Redstar030/AERC_Forklift/resources/sch.pdf

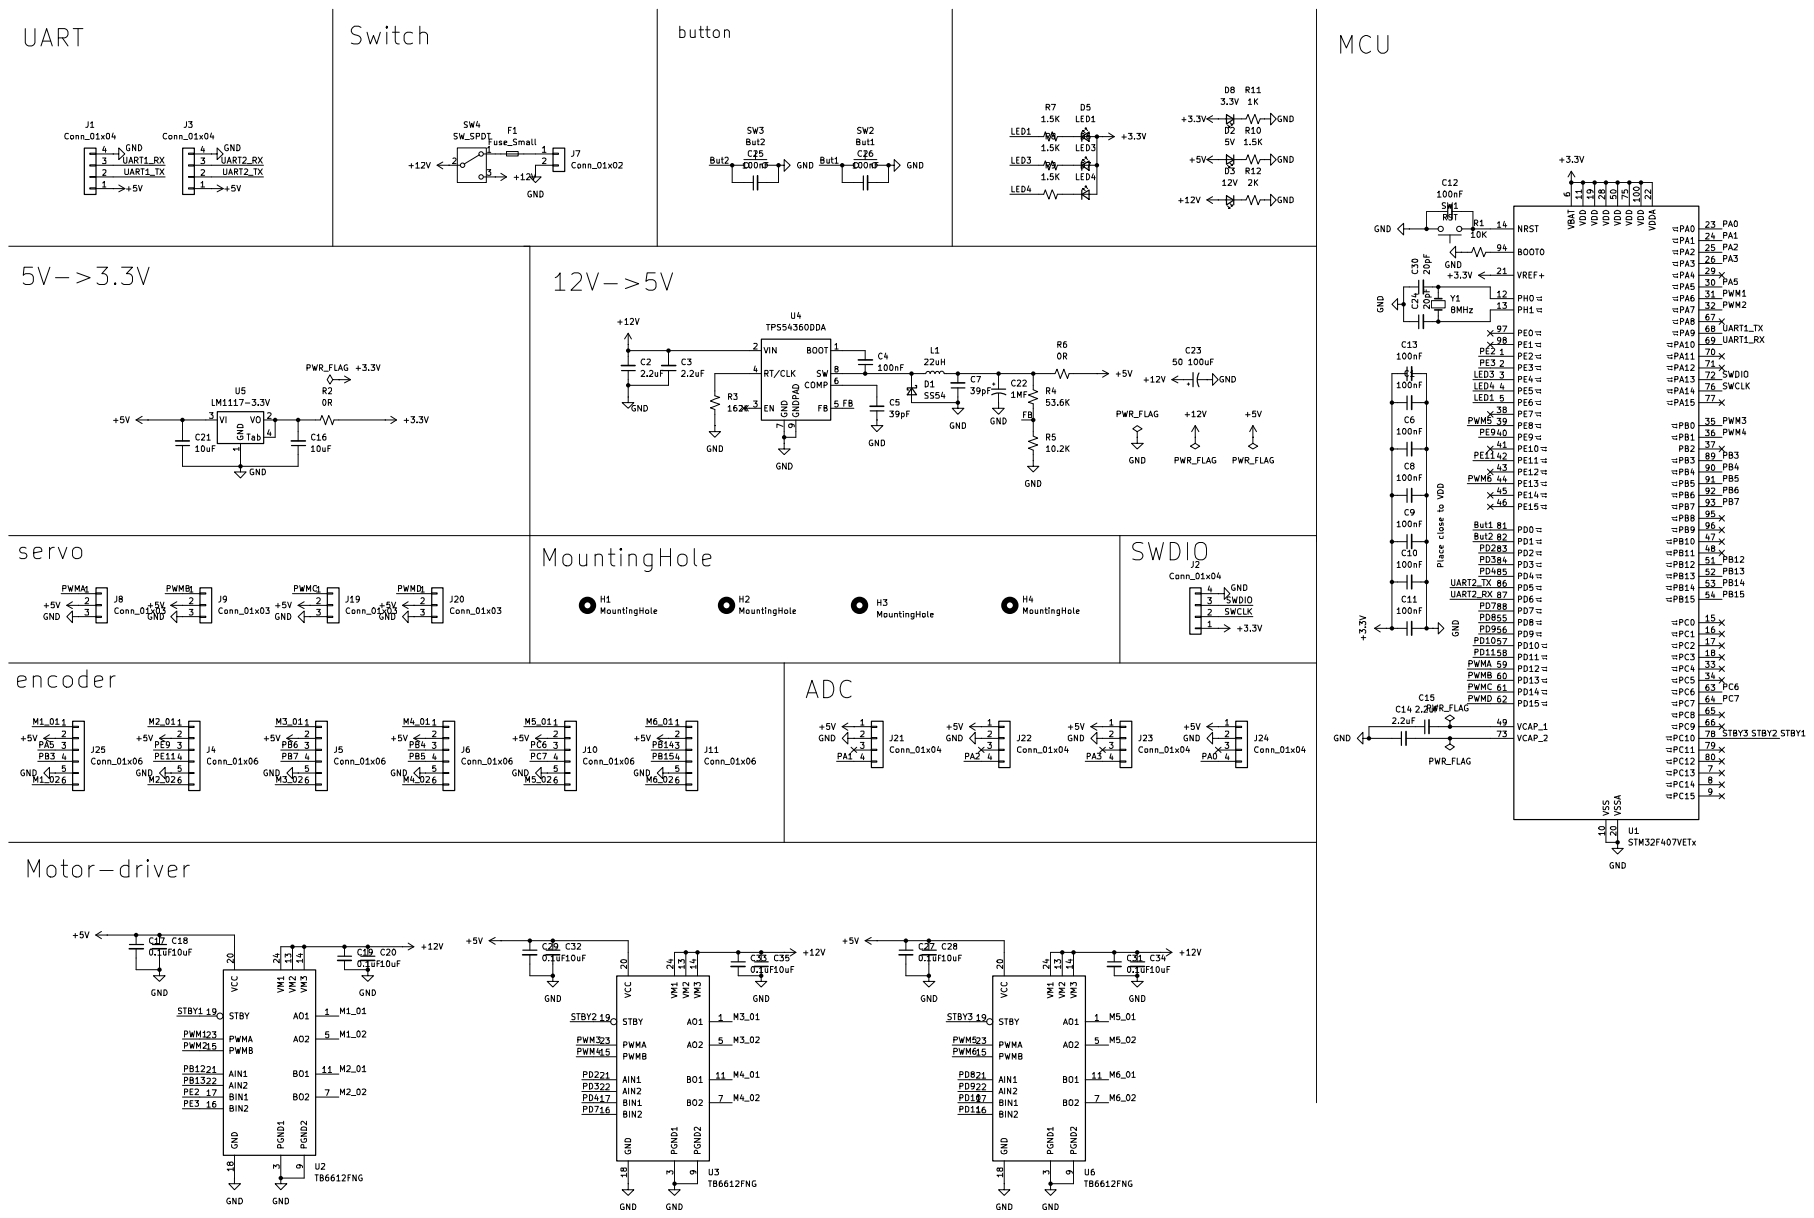
[picture p1: page 1]
