Redstar030/AERC_Forklift/resources/forklift3.0.kicad_pcb

## KiCad design resources/forklift3.0.kicad_pcb (2026-05-13)

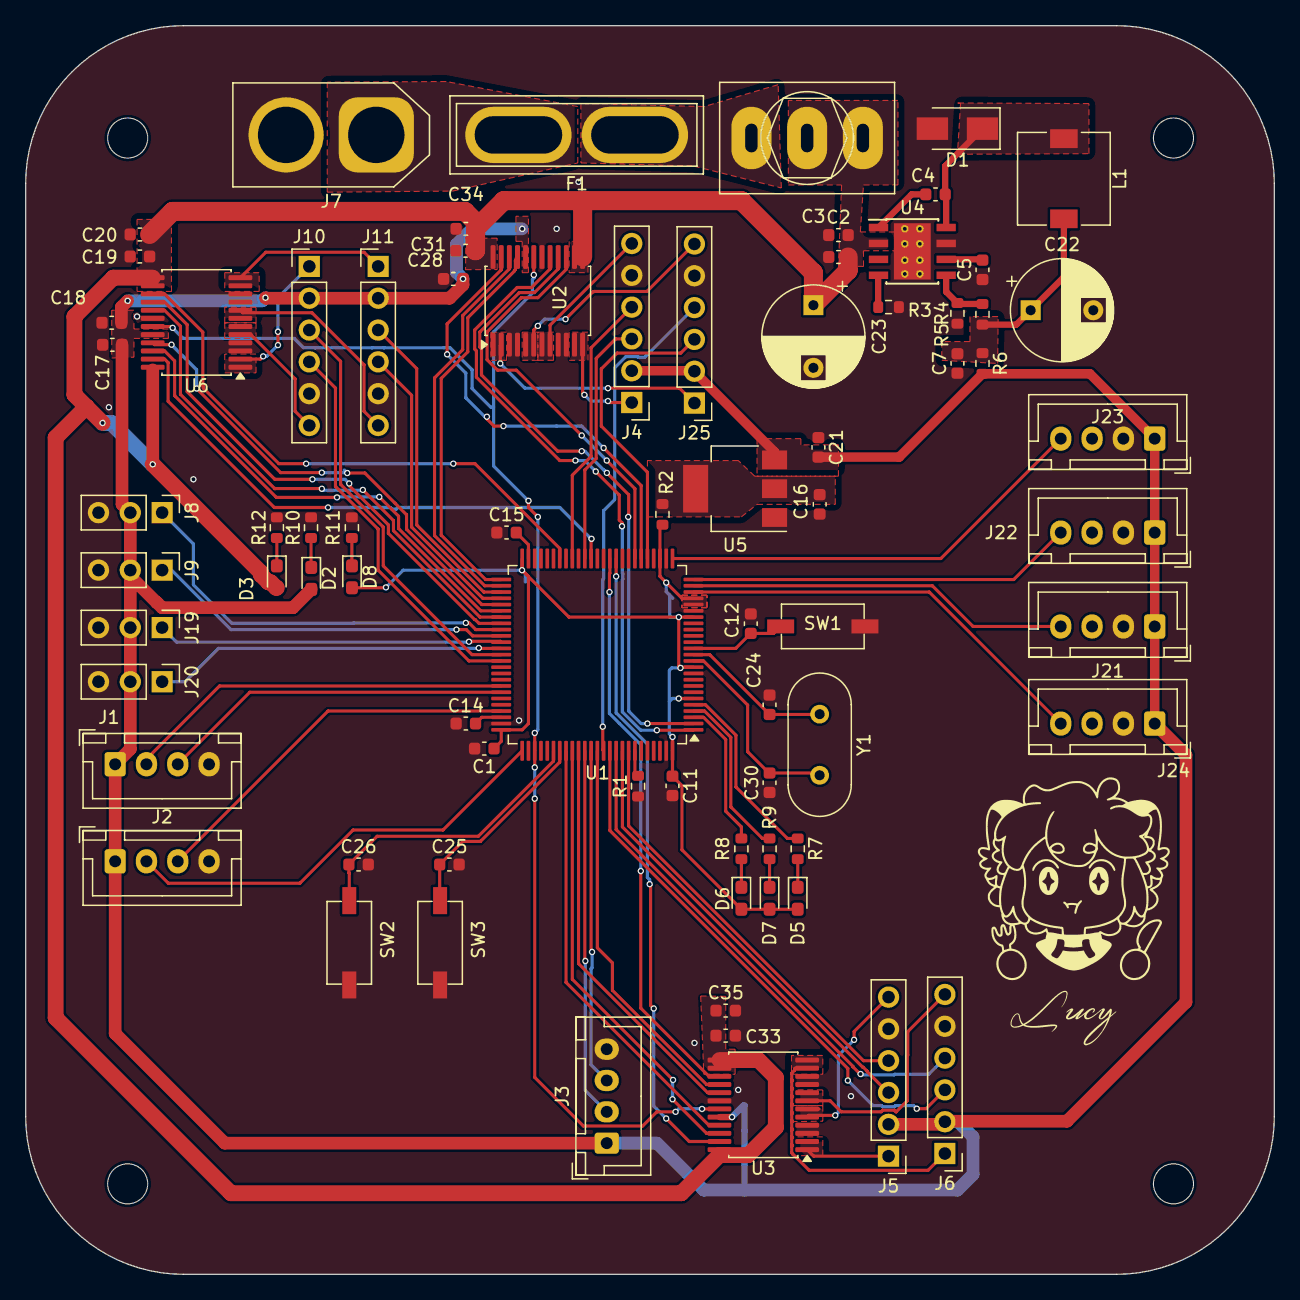
[picture p2: board forklift3.0.kicad_pcb from above]

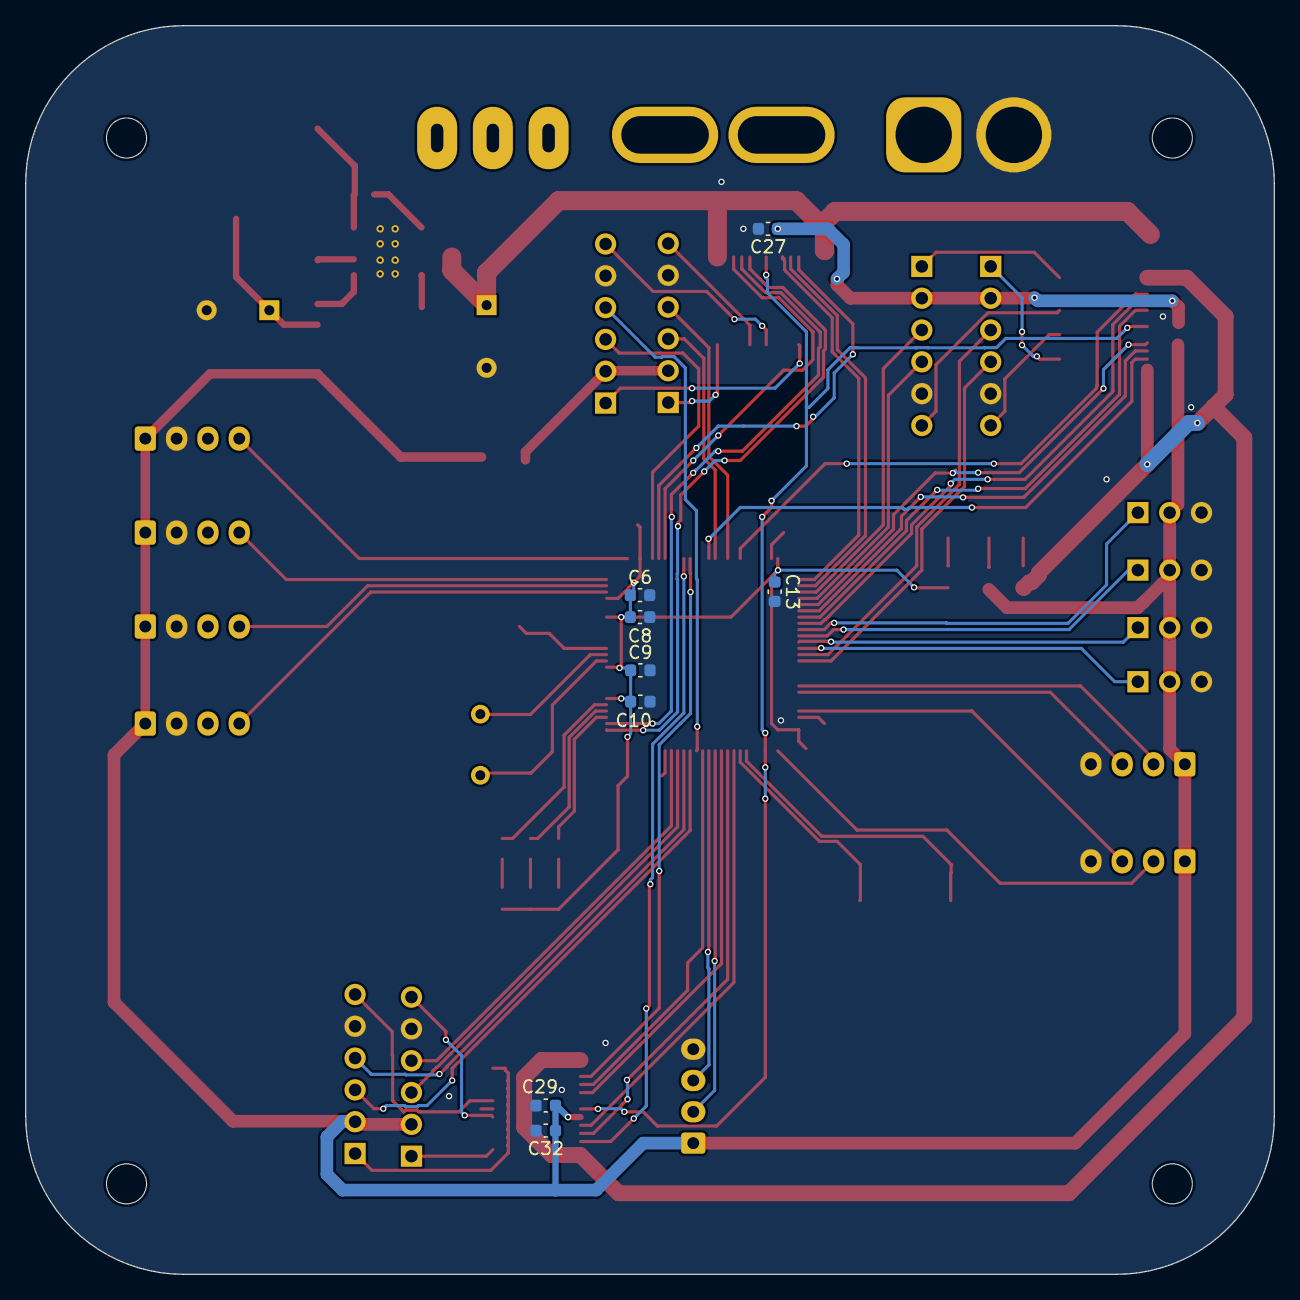
[picture p3: board forklift3.0.kicad_pcb from below]

Board: 2 copper layers, 99.7 x 99.7 mm, 89 parts (8 on the bottom side), 87 nets.

Parts:
C1, C4, C6, C8, C9, C10, C11, C12, C13, C25, C26: 100nF; C_0603_1608Metric
C2, C3, C14, C15: 2.2uF; C_0603_1608Metric
C5, C7: 39pF; C_0603_1608Metric
C16, C18, C20, C21, C28, C32, C34, C35: 10uF; C_0603_1608Metric
C17, C19, C27, C29, C31, C33: 0.1uF; C_0603_1608Metric
C22: 1MF; CP_Radial_D8.0mm_P12.00mm
C23: 50 100uF; CP_Radial_D8.0mm_P12.00mm
C24, C30: 20pF; C_0603_1608Metric
D1: SS54; D_SMA
D2: 5V; LED_0603_1608Metric_Pad1.05x0.95mm_HandSolder
D3: 12V; LED_0603_1608Metric_Pad1.05x0.95mm_HandSolder
D5: LED1; LED_0603_1608Metric_Pad1.05x0.95mm_HandSolder
D6: LED3; LED_0603_1608Metric_Pad1.05x0.95mm_HandSolder
D7: LED4; LED_0603_1608Metric_Pad1.05x0.95mm_HandSolder
D8: 3.3V; LED_0603_1608Metric_Pad1.05x0.95mm_HandSolder
F1: Fuse_Small; Fuse_Blade_ATO_directSolder
H1, H2, H3, H4: MountingHole; MountingHole_3.2mm_M3
J1, J2, J3, J21, J22, J23, J24: Conn_01x04; JST_XH_B4B-XH-A_1x04_P2.50mm_Vertical
J4, J5, J6, J10, J11, J25: Conn_01x06; PinHeader_1x06_P2.54mm_Vertical
J7: Conn_01x02; AMASS_XT60-M_1x02_P7.20mm_Vertical
J8, J9, J19, J20: Conn_01x03; PinHeader_1x03_P2.54mm_Vertical
L1: 22uH; L_7.3x7.3_H3.5
R1: 10K; R_0603_1608Metric
R2, R6: 0R; R_0603_1608Metric
R3: 162K; R_0603_1608Metric
R4: 53.6K; R_0603_1608Metric
R5: 10.2K; R_0603_1608Metric
R7, R8, R9, R10: 1.5K; R_0603_1608Metric
R11: 1K; R_0603_1608Metric
R12: 2K; R_0603_1608Metric
SW1: RST; SW_Push
SW2: But1; SW_Push
SW3: But2; SW_Push
SW4: SW_SPDT; SW_Toggle_Blue_wSlots
U1: STM32F407VETx; LQFP-100_14x14mm_P0.5mm
U2, U3, U6: TB6612FNG; SSOP-24_5.3x8.2mm_P0.65mm
U4: TPS54360DDA; TI_SO-PowerPAD-8_ThermalVias
U5: LM1117-3.3V; SOT-223
Y1: 8MHz; Crystal_HC49-4H_Vertical

Connections:
+3.3V: C1.1, C6.1, C8.1, C9.1, C10.1, C11.1, C13.1, D5.2 (A), D6.2 (A), D7.2 (A), D8.2 (A), R2.2, U1.6 (VBAT), U1.11 (VDD), U1.19 (VDD), U1.21 (VREF+), U1.22 (VDDA), U1.28 (VDD), U1.50 (VDD), U1.75 (VDD), U1.100 (VDD)
+5V: C17.1, C18.1, C21.2, C27.1, C28.1, C29.1, C32.1, D2.2 (A), J1.1, J2.1, J3.1, J4.2, J5.2, J6.2, J8.2, J9.2, J10.2, J11.2, J19.2, J20.2, J21.1, J22.1, J23.1, J24.1, J25.2, R6.2, U2.20 (VCC), U3.20 (VCC), U5.3 (VI), U6.20 (VCC)
+12V: C2.2, C3.2, C19.1, C20.1, C23.1, C31.1, C33.1, C34.1, C35.1, D3.2 (A), SW4.2 (B), SW4.3 (C), U2.13 (VM2), U2.14 (VM3), U2.24 (VM1), U3.13 (VM2), U3.14 (VM3), U3.24 (VM1), U4.2 (VIN), U6.13 (VM2), U6.14 (VM3), U6.24 (VM1)
/But1: C26.1, SW2.1, U1.81 (PD0)
/But2: C25.1, SW3.1, U1.82 (PD1)
/FB: R4.2, R5.1, U4.5 (FB)
/LED1: R7.1, U1.5 (PE6)
/LED3: R8.1, U1.3 (PE4)
/LED4: R9.1, U1.4 (PE5)
/M1_01: J25.1, U2.1 (AO1), U2.2 (AO1)
/M1_02: J25.6, U2.5 (AO2), U2.6 (AO2)
/M2_01: J4.1, U2.11 (BO1), U2.12 (BO1)
/M2_02: J4.6, U2.7 (BO2), U2.8 (BO2)
/M3_01: J5.1, U3.1 (AO1), U3.2 (AO1)
/M3_02: J5.6, U3.5 (AO2), U3.6 (AO2)
/M4_01: J6.1, U3.11 (BO1), U3.12 (BO1)
/M4_02: J6.6, U3.7 (BO2), U3.8 (BO2)
/M5_01: J10.1, U6.1 (AO1), U6.2 (AO1)
/M5_02: J10.6, U6.5 (AO2), U6.6 (AO2)
/M6_01: J11.1, U6.11 (BO1), U6.12 (BO1)
/M6_02: J11.6, U6.7 (BO2), U6.8 (BO2)
/PA0: J24.4, U1.23 (PA0)
/PA1: J21.4, U1.24 (PA1)
/PA2: J22.4, U1.25 (PA2)
/PA3: J23.4, U1.26 (PA3)
/PA5: J25.3, U1.30 (PA5)
/PB3: J25.4, U1.89 (PB3)
/PB4: J6.3, U1.90 (PB4)
/PB5: J6.4, U1.91 (PB5)
/PB6: J5.3, U1.92 (PB6)
/PB7: J5.4, U1.93 (PB7)
/PB12: U1.51 (PB12), U2.21 (AIN1)
/PB13: U1.52 (PB13), U2.22 (AIN2)
/PB14: J11.3, U1.53 (PB14)
/PB15: J11.4, U1.54 (PB15)
/PC6: J10.3, U1.63 (PC6)
/PC7: J10.4, U1.64 (PC7)
/PD2: U1.83 (PD2), U3.21 (AIN1)
/PD3: U1.84 (PD3), U3.22 (AIN2)
/PD4: U1.85 (PD4), U3.17 (BIN1)
/PD7: U1.88 (PD7), U3.16 (BIN2)
/PD8: U1.55 (PD8), U6.21 (AIN1)
/PD9: U1.56 (PD9), U6.22 (AIN2)
/PD10: U1.57 (PD10), U6.17 (BIN1)
/PD11: U1.58 (PD11), U6.16 (BIN2)
/PE2: U1.1 (PE2), U2.17 (BIN1)
/PE3: U1.2 (PE3), U2.16 (BIN2)
/PE9: J4.3, U1.40 (PE9)
/PE11: J4.4, U1.42 (PE11)
/PWM1: U1.31 (PA6), U2.23 (PWMA)
/PWM2: U1.32 (PA7), U2.15 (PWMB)
/PWM3: U1.35 (PB0), U3.23 (PWMA)
/PWM4: U1.36 (PB1), U3.15 (PWMB)
/PWM5: U1.39 (PE8), U6.23 (PWMA)
/PWM6: U1.44 (PE13), U6.15 (PWMB)
/PWMA: J8.1, U1.59 (PD12)
/PWMB: J9.1, U1.60 (PD13)
/PWMC: J19.1, U1.61 (PD14)
/PWMD: J20.1, U1.62 (PD15)
/STBY1: U1.78 (PC10), U2.19 (STBY), U3.19 (STBY), U6.19 (STBY)
/SWCLK: J2.2, U1.76 (PA14)
/SWDIO: J2.3, U1.72 (PA13)
/UART1_RX: J1.3, U1.69 (PA10)
/UART1_TX: J1.2, U1.68 (PA9)
/UART2_RX: J3.3, U1.87 (PD6)
/UART2_TX: J3.2, U1.86 (PD5)
GND: C1.2, C2.1, C3.1, C5.1, C6.2, C7.1, C8.2, C9.2, C10.2, C11.2, C12.1, C13.2, C14.1, C15.1, C16.1, C17.2, C18.2, C19.2, C20.2, C21.1, C22.2, C23.2, C24.1, C25.2, C26.2, C27.2, C28.2, C29.2, C30.1, C31.2, C32.2, C33.2, C34.2, C35.2, D1.2 (A), J1.4, J2.4, J3.4, J4.5, J5.5, J6.5, J7.2, J8.3, J9.3, J10.5, J11.5, J19.3, J20.3, J21.2, J22.2, J23.2, J24.2, J25.5, R1.1, R3.2, R5.2, R10.2, R11.2, R12.2, SW1.2, SW2.2, SW3.2, U1.10 (VSS), U1.20 (VSSA), U1.27 (VSS), U1.74 (VSS), U1.99 (VSS), U2.3 (PGND1), U2.4 (PGND1), U2.9 (PGND2), U2.10 (PGND2), U2.18 (GND), U3.3 (PGND1), U3.4 (PGND1), U3.9 (PGND2), U3.10 (PGND2), U3.18 (GND), U4.7 (GND), U4.9 (GNDPAD), U5.1 (GND), U6.3 (PGND1), U6.4 (PGND1), U6.9 (PGND2), U6.10 (PGND2), U6.18 (GND)
unnamed: C7.2, C22.1, L1.2, R4.1, R6.1
unnamed: C4.1, D1.1 (K), L1.1, U4.8 (SW)
unnamed: D2.1 (K), R10.1
unnamed: D3.1 (K), R12.1
unnamed: D5.1 (K), R7.2
unnamed: D6.1 (K), R8.2
unnamed: D7.1 (K), R9.2
unnamed: D8.1 (K), R11.1
unnamed: F1.2, J7.1
unnamed: F1.1, SW4.1 (A)
unnamed: R1.2, U1.94 (BOOT0)
unnamed: C12.2, SW1.1, U1.14 (NRST)
unnamed: C30.2, U1.12 (PH0), Y1.2
unnamed: C24.2, U1.13 (PH1), Y1.1
unnamed: C15.2, U1.49 (VCAP_1)
unnamed: C14.2, U1.73 (VCAP_2)
unnamed: C4.2, U4.1 (BOOT)
unnamed: C5.2, U4.6 (COMP)
unnamed: R3.1, U4.4 (RT/CLK)
unnamed: C16.2, R2.1, U5.2 (VO), U5.4 (Tab)
