Redstar030/AERC_Forklift/AERC_Forklift.ioc

Mcu.UserName=STM32F407VETx
PA0-WKUP.Signal=S_TIM5_CH1
PA1.Signal=S_TIM5_CH2
PA10.Signal=USART1_RX
PA13.Signal=SYS_JTMS-SWDIO
PA14.Signal=SYS_JTCK-SWCLK
PA5.GPIO_Label=ENC1A
PA5.Signal=S_TIM2_CH1_ETR
PA6.GPIO_Label=M1_PWMA
PA6.Signal=S_TIM3_CH1
PA7.GPIO_Label=M1_PWMB
PA7.Signal=S_TIM3_CH2
PA9.Signal=USART1_TX
PB0.GPIO_Label=M3_PWMA
PB0.Signal=S_TIM3_CH3
PB1.GPIO_Label=M3_PWMB
PB1.Signal=S_TIM3_CH4
PB12.GPIO_Label=M2_AIN1
PB12.Signal=GPIO_Output
PB13.GPIO_Label=M2_AIN2
PB13.Signal=GPIO_Output
PB14.GPIO_Label=ENC4A
PB14.Signal=S_TIM12_CH1
PB15.GPIO_Label=ENC4B
PB15.Signal=S_TIM12_CH2
PB3.GPIO_Label=ENC1B
PB3.Signal=S_TIM2_CH2
PC10.GPIO_Label=STBY_ALL
PC10.Signal=GPIO_Output
PC6.GPIO_Label=ENC3A
PC6.Signal=S_TIM8_CH1
PC7.GPIO_Label=ENC3B
PC7.Signal=S_TIM8_CH2
PD0.GPIO_Label=But2
PD0.Signal=GPIO_Input
PD1.GPIO_Label=But1
PD1.Signal=GPIO_Input
PD10.GPIO_Label=slider2A
PD10.Signal=GPIO_Output
PD11.GPIO_Label=slider2B
PD11.Signal=GPIO_Output
PD2.GPIO_Label=M3_AIN1
PD2.Signal=GPIO_Output
PD3.GPIO_Label=M3_AIN2
PD3.Signal=GPIO_Output
PD4.GPIO_Label=M3_BIN1
PD4.Signal=GPIO_Output
PD5.Signal=USART2_TX
PD6.Signal=USART2_RX
PD7.GPIO_Label=M3_BIN2
PD7.Signal=GPIO_Output
PD8.GPIO_Label=slider1A
PD8.Signal=GPIO_Output
PD9.GPIO_Label=slider1B
PD9.Signal=GPIO_Output
PE13.GPIO_Label=fork2
PE13.Signal=GPIO_Output
PE2.GPIO_Label=M2_BIN1
PE2.Signal=GPIO_Output
PE3.GPIO_Label=M2_BIN2
PE3.Signal=GPIO_Output
PE4.GPIO_Label=LED3
PE4.Signal=GPIO_Output
PE5.GPIO_Label=LED4
PE5.Signal=GPIO_Output
PE6.GPIO_Label=LED1
PE6.Signal=GPIO_Output
PE8.GPIO_Label=fork1 
PE8.Signal=GPIO_Output
PE9.GPIO_Label=ENC2A
PE9.Signal=S_TIM1_CH1
PH0-OSC_IN.Signal=RCC_OSC_IN
PH1-OSC_OUT.Signal=RCC_OSC_OUT
