Redstar030/AERC_Forklift/Core/Inc/controller.h

#ifndef CONTROLLER_H
#define CONTROLLER_H

void Controller_Init(void);
void Controller_Update(void);

#endif
/*#ifndef CONTROLLER_H
#define CONTROLLER_H
#include "main.h"

void Controller_Init(void);
void Controller_Update(void); 

#endif*/
