Redstar030/AERC_Forklift/Core/Inc/fork.h

#ifndef FORK_H
#define FORK_H
#include "main.h"

void Fork_Init(void);
void Fork1_Up(void);      
void Fork1_Down(void);    
void Fork1_Stop(void);

void Fork2_Up(void);      
void Fork2_Down(void);    
void Fork2_Stop(void);
#endif
