Redstar030/AERC_Forklift/(commit log)

2026-04-12 motor working
2026-04-12 encoder initialize
2026-04-12 encoder testing
2026-05-13 ps4 ini
    [forklift3.0.kicad_pcb]
